bryanbendall/Brytec_InputModuleRev2/Board/Brytec_InputModuleRev2/Brytec_InputModuleRev2.kicad_pcb

## KiCad design Board/Brytec_InputModuleRev2/Brytec_InputModuleRev2.kicad_pcb (2024-01-26)

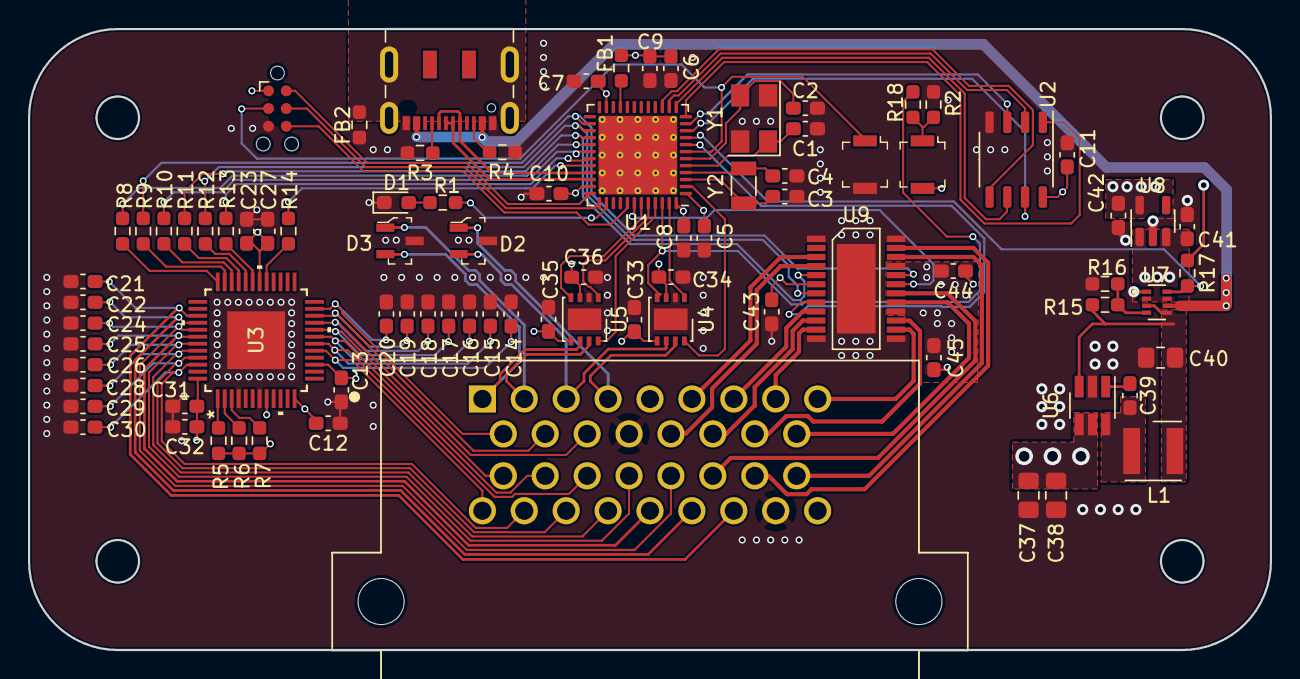
[picture p1: board Brytec_InputModuleRev2.kicad_pcb from above]

Board: 4 copper layers, 88.9 x 44.5 mm, 85 parts (0 on the bottom side), 88 nets.

Parts:
C1, C2, C3, C4: 10pF; C_0603_1608Metric_Pad1.08x0.95mm_HandSolder
C5, C7, C8, C10, C11, C12, C13, C27, C32, C33, C34, C35, C36, C39, C43, C44, C45: 0.1uF; C_0603_1608Metric_Pad1.08x0.95mm_HandSolder
C6, C23, C31, C41, C42: 1uF; C_0603_1608Metric_Pad1.08x0.95mm_HandSolder
C9: 10nF; C_0603_1608Metric_Pad1.08x0.95mm_HandSolder
C14, C15, C16, C17, C18, C19, C20, C21, C22, C24, C25, C26, C28, C29, C30: 6.8nF; C_0603_1608Metric_Pad1.08x0.95mm_HandSolder
C37: 4.7uF; C_0805_2012Metric_Pad1.18x1.45mm_HandSolder
C38: 0.1uF; C_0805_2012Metric_Pad1.18x1.45mm_HandSolder
C40: 10uF; C_0805_2012Metric_Pad1.18x1.45mm_HandSolder
D1: LED_Small; LED_0603_1608Metric_Pad1.05x0.95mm_HandSolder
D2, D3: PESD2CAN_215; SOT-23-3
FB1, FB2: FerriteBead_Small; R_0603_1608Metric_Pad0.98x0.95mm_HandSolder
J1: Conn_ARM_SWD_TagConnect_TC2030-NL; Tag-Connect_TC2030-IDC-NL_2x03_P1.27mm_Vertical
J2: USB_C_Receptacle_USB2.0; USB_C_Receptacle_JAE_DX07S016JA1R1500
J3: 6437288-2; TE_6437288-2
L1: 6.8uH; L_Wurth_WE-LQSH-4020
R1: 65; R_0603_1608Metric_Pad0.98x0.95mm_HandSolder
R2, R15, R16, R17: 10K; R_0603_1608Metric_Pad0.98x0.95mm_HandSolder
R3, R4: 5.1K; R_0603_1608Metric_Pad0.98x0.95mm_HandSolder
R5: 50K; R_0603_1608Metric_Pad0.98x0.95mm_HandSolder
R6: 9K; R_0603_1608Metric_Pad0.98x0.95mm_HandSolder
R7: 180; R_0603_1608Metric_Pad0.98x0.95mm_HandSolder
R8, R9, R10, R11, R12, R13, R14: 1K; R_0603_1608Metric_Pad0.98x0.95mm_HandSolder
R18: 0; R_0603_1608Metric_Pad0.98x0.95mm_HandSolder
S1, S2: B3U-1000P; Switch_Tactile_SMD_B3U-1000P
U1: STM32G491CEUx; QFN-48-1EP_7x7mm_P0.5mm_EP5.6x5.6mm_ThermalVias
U2: MB85RS64; SSOP-8_3.9x5.05mm_P1.27mm
U3: L9966CB-TR; TQFP48_L9966_STM
U4, U5: MCP2558FD-xMF; DFN-8-1EP_3x3mm_P0.65mm_EP1.55x2.4mm
U6: LMR50410Y5FQDBVRQ1; SOT-23-6_Handsoldering
U7: TPS2116DRLR; SOTFL50P160X60-8N
U8: AP2112K-3.3; SOT-23-5
U9: TLE94112ES; Infineon_TSDSO-24
Y1: 8MHz; Crystal_SMD_5032-4Pin_5.0x3.2mm
Y2: 32.768kHz; Crystal_SMD_3215-2Pin_3.2x1.5mm

Connections:
+3.3V: C5.2, C6.2, C7.2, C8.2, C9.2, C10.2, C11.1, C33.1, C35.1, C42.1, C43.2, FB1.1, J1.1 (VCC), R17.1, S2.2, U1.1 (VBAT), U1.23 (VDD), U1.35 (VDD), U1.48 (VDD), U2.8 (VDD), U4.5 (VIO), U5.5 (VIO), U8.5 (VOUT), U9.6 (VDD)
+5V: C12.2, C23.1, C27.1, C34.1, C36.1, C41.1, J3.5, R5.1, R6.1, R7.1, U3.8 (VDD5REF), U3.12 (VI5V), U3.30 (VDD5V), U4.3 (VDD), U5.3 (VDD), U7.2 (VOUT), U7.7 (VOUT), U8.1 (VIN), U8.3 (EN)
/Mcu/Memory_Hold: U1.10 (PA2), U2.7 (~HOLD)
/Mcu/Memory_Wp: U1.11 (PA3), U2.3 (~WP)
/Mcu/RESET: J1.3 (~RESET), S1.1, U1.7 (PG10)
/Mcu/SWCLK: J1.4 (SWCLK), U1.37 (PA14)
/Mcu/SWDIO: J1.2 (SWDIO), U1.36 (PA13)
/Mcu/SWO: J1.6 (SWO), U1.41 (PB3)
/Mcu/Usb D+: J2.A6 (D+), J2.B6 (D+), U1.34 (PA12)
/Mcu/Usb D-: J2.A7 (D-), J2.B7 (D-), U1.33 (PA11)
/Mcu/Usb_Shield: FB2.1, J2.S1 (SHIELD)
/Mcu/User_Led: R1.1, U1.38 (PA15)
Can1+: D2.1 (C1), J3.4, U4.7 (CANH)
Can1-: D2.2 (C2), J3.3, U4.6 (CANL)
Can1Rx: R18.1, U1.46 (PB8), U4.4 (RXD)
Can1Silent: U1.2 (PC13), U4.8 (S)
Can1Tx: U1.47 (PB9), U4.1 (TXD)
Can2+: D3.1 (C1), J3.2, U5.7 (CANH)
Can2-: D3.2 (C2), J3.1, U5.6 (CANL)
Can2Rx: U1.43 (PB5), U5.4 (RXD)
Can2Silent: U1.45 (PB7), U5.8 (S)
Can2Tx: U1.44 (PB6), U5.1 (TXD)
GND: C1.1, C2.1, C3.1, C4.1, C5.1, C6.1, C7.1, C8.1, C9.1, C10.1, C11.2, C12.1, C13.1, C14.2, C15.2, C16.2, C17.2, C18.2, C19.2, C20.2, C21.2, C22.2, C23.2, C24.2, C25.2, C26.2, C27.2, C28.2, C29.2, C30.2, C31.2, C32.2, C33.2, C34.2, C35.2, C36.2, C37.2, C38.2, C40.2, C41.2, C42.2, C43.1, C44.1, C45.1, D1.1 (K), D2.3 (C3), D3.3 (C3), FB2.2, J1.5 (GND), J2.A1 (GND), J2.A12 (GND), J2.B1 (GND), J2.B12 (GND), J3.13, J3.33, R2.2, R3.2, R4.2, R16.2, S1.2, U1.49 (VSS), U2.4 (GND), U3.4 (R_GND), U3.7 (GND), U3.EPAD, U4.2 (VSS), U4.9 (VSS), U5.2 (VSS), U5.9 (VSS), U6.2 (GND), U7.1 (GND), U8.2 (GND), U9.1 (GND), U9.12 (GND), U9.13 (GND), U9.24 (GND), U9.EDP (GND), Y1.2, Y1.4
Ignition: C13.2, C31.1, C32.1, C37.1, C38.1, C44.2, C45.2, J3.34, U3.15 (VIX), U3.48 (UBSW), U6.4 (EN), U6.5 (VIN), U9.16 (VS1), U9.21 (VS2)
Input1: C30.1, J3.27, U3.46 (IO_5)
Input2: C29.1, J3.28, U3.45 (IO_6)
Input3: C28.1, J3.29, U3.44 (IO_7)
Input4: C26.1, J3.21, U3.43 (IO_8)
Input5: C25.1, J3.30, U3.42 (IO_9)
Input6: C24.1, J3.22, U3.41 (IO_10)
Input7: C22.1, J3.31, U3.40 (IO_11)
Input8: C21.1, J3.32, U3.39 (IO_12)
Input9: C14.1, J3.26, U3.17 (IO_13)
Input10: C15.1, J3.20, U3.18 (IO_14)
Input11: C16.1, J3.19, U3.19 (IO_15)
Input12: C17.1, J3.18, U3.20 (IO_1)
Input13: C18.1, J3.12, U3.21 (IO_2)
Input14: C19.1, J3.11, U3.22 (IO_3)
Input15: C20.1, J3.10, U3.23 (IO_4)
L6699-Int: R14.2, U1.32 (PA10)
L6699-Rst: R8.2, U1.29 (PC6)
L6699-Sync: R13.2, U1.31 (PA9)
unnamed: D1.2 (A), R1.2
unnamed: J2.A5 (CC1), R4.1
unnamed: J2.B5 (CC2), R3.1
unnamed: R2.1, R18.2, S2.1
unnamed: C3.2, U1.3 (PC14), Y2.2
unnamed: C4.2, U1.4 (PC15), Y2.1
unnamed: C1.2, U1.5 (PF0), Y1.1
unnamed: C2.2, U1.6 (PF1), Y1.3
unnamed: FB1.2, U1.21 (VDDA)
unnamed: R10.1, U3.34 (CS)
unnamed: R14.1, U3.29 (INT)
unnamed: R12.1, U3.32 (MISO)
unnamed: R11.1, U3.33 (MOSI)
unnamed: R7.2, U3.3 (RR1)
unnamed: R6.2, U3.2 (RR2)
unnamed: R5.2, U3.1 (RR3)
unnamed: R8.1, U3.36 (RST)
unnamed: R9.1, U3.35 (SCLK)
unnamed: R13.1, U3.31 (SYNC)
unnamed: C39.2, U6.1 (CB)
unnamed: C39.1, L1.1, U6.6 (SW)
unnamed: R15.2, R16.1, U7.4 (PR1)
Out2: J3.24, U9.23 (OUT2)
Out3: J3.9, U9.14 (OUT3)
Out4: J3.8, U9.11 (OUT4)
Out5: J3.6, U9.3 (OUT5)
Out6: J3.15, U9.10 (OUT6)
Out7: J3.14, U9.4 (OUT7)
Out8: J3.25, U9.22 (OUT8)
Out9: J3.7, U9.9 (OUT9)
Out10: J3.16, U9.15 (OUT10)
Out11: J3.17, U9.17 (OUT11)
Out12: J3.23, U9.18 (OUT12)
PowerSwitchStatus: R17.2, U1.9 (PA1), U7.8 (ST)
Regulated 5V: C40.1, L1.2, R15.1, U6.3 (FB), U7.3 (VIN1), U7.5 (MODE)
SPI1_Miso: U1.14 (PA6), U2.2 (SO)
SPI1_Mosi: U1.15 (PA7), U2.5 (SI)
SPI1_SS: U1.12 (PA4), U2.1 (~CS)
SPI1_Sclk: U1.13 (PA5), U2.6 (SCK)
SPI2_Miso: R12.2, U1.27 (PB14), U9.7 (SDO)
SPI2_Mosi: R11.2, U1.28 (PB15), U9.5 (SDI)
SPI2_SS_L9966: R10.2, U1.30 (PA8)
SPI2_SS_TLE94112: U1.42 (PB4), U9.19 (CSN)
SPI2_Sclk: R9.2, U1.26 (PB13), U9.20 (SCLK)
TLE94112_EN: U1.8 (PA0), U9.8 (EN)
Usb 5V: J2.A4 (VBUS), J2.A9 (VBUS), J2.B4 (VBUS), J2.B9 (VBUS), U7.6 (VIN2)
