bryanbendall/Brytec_InputModuleRev2/Firmware/InputModuleRev2.ioc

Mcu.UserName=STM32G491CEUx
PA0.GPIO_Label=TLE94112_EN
PA0.Signal=GPIO_Output
PA1.GPIO_Label=PowerSwitchStatus
PA1.Signal=GPIO_Input
PA10.GPIO_Label=L9966-Int
PA10.Signal=GPIO_Input
PA11.Signal=USB_DM
PA12.Signal=USB_DP
PA13.Signal=SYS_JTMS-SWDIO
PA14.Signal=SYS_JTCK-SWCLK
PA15.GPIO_Label=User_Led
PA15.Signal=GPIO_Output
PA2.GPIO_Label=Memory_Hold
PA2.Signal=GPIO_Output
PA3.GPIO_Label=Memory_Wp
PA3.Signal=GPIO_Output
PA4.GPIO_Label=Memory_SS
PA4.Signal=GPIO_Output
PA5.Signal=SPI1_SCK
PA6.Signal=SPI1_MISO
PA7.Signal=SPI1_MOSI
PA8.GPIO_Label=SPI_SS_L9966
PA8.Signal=GPIO_Output
PA9.GPIO_Label=L9966-Sync
PA9.Signal=GPIO_Output
PB13.Signal=SPI2_SCK
PB14.Signal=SPI2_MISO
PB15.Signal=SPI2_MOSI
PB4.GPIO_Label=SPI2_SS_TLE94112
PB4.Signal=GPIO_Output
PB5.Signal=FDCAN2_RX
PB6.Signal=FDCAN2_TX
PB7.GPIO_Label=Can2Silent
PB7.Signal=GPIO_Output
PB8-BOOT0.Signal=FDCAN1_RX
PB9.Signal=FDCAN1_TX
PC13.GPIO_Label=Can1Silent
PC13.Signal=GPIO_Output
PC14-OSC32_IN.Signal=RCC_OSC32_IN
PC15-OSC32_OUT.Signal=RCC_OSC32_OUT
PC6.GPIO_Label=L9966-Rst
PC6.Signal=GPIO_Output
PF0-OSC_IN.Signal=RCC_OSC_IN
PF1-OSC_OUT.Signal=RCC_OSC_OUT
