bryanbendall/Brytec_InputModuleRev2/Firmware/App/BoardHardware.cpp

#include "BoardHardware.h"

#include "Stm32Output.h"
#include "spi.h"
#include <stdio.h>

enum class SpiState {
    TLE94112,
    L9966
};

static SpiState s_spiState = SpiState::TLE94112;

bool BoardHardware::getIgntionPowerState()
{
    return HAL_GPIO_ReadPin(PowerSwitchStatus_GPIO_Port, PowerSwitchStatus_Pin);
}

void BoardHardware::setSpiTLE94112()
{
    if (s_spiState == SpiState::TLE94112)
        return;

    HAL_SPI_DeInit(&hspi2);

    hspi2.Instance = SPI2;
    hspi2.Init.Mode = SPI_MODE_MASTER;
    hspi2.Init.Direction = SPI_DIRECTION_2LINES;
    hspi2.Init.DataSize = SPI_DATASIZE_8BIT;
    hspi2.Init.CLKPolarity = SPI_POLARITY_LOW;
    hspi2.Init.CLKPhase = SPI_PHASE_2EDGE;
    hspi2.Init.NSS = SPI_NSS_SOFT;
    hspi2.Init.BaudRatePrescaler = SPI_BAUDRATEPRESCALER_32;
    hspi2.Init.FirstBit = SPI_FIRSTBIT_LSB;
    hspi2.Init.TIMode = SPI_TIMODE_DISABLE;
    hspi2.Init.CRCCalculation = SPI_CRCCALCULATION_DISABLE;
    hspi2.Init.CRCPolynomial = 7;
    hspi2.Init.CRCLength = SPI_CRC_LENGTH_DATASIZE;
    hspi2.Init.NSSPMode = SPI_NSS_PULSE_DISABLE;
    if (HAL_SPI_Init(&hspi2) != HAL_OK) {
        Error_Handler();
    }

    s_spiState = SpiState::TLE94112;
}

void BoardHardware::setSpiL9966()
{
    if (s_spiState == SpiState::L9966)
        return;

    HAL_SPI_DeInit(&hspi2);

    hspi2.Instance = SPI2;
    hspi2.Init.Mode = SPI_MODE_MASTER;
    hspi2.Init.Direction = SPI_DIRECTION_2LINES;
    hspi2.Init.DataSize = SPI_DATASIZE_16BIT;
    hspi2.Init.CLKPolarity = SPI_POLARITY_LOW;
    hspi2.Init.CLKPhase = SPI_PHASE_2EDGE;
    hspi2.Init.NSS = SPI_NSS_SOFT;
    hspi2.Init.BaudRatePrescaler = SPI_BAUDRATEPRESCALER_32;
    hspi2.Init.FirstBit = SPI_FIRSTBIT_MSB;
    hspi2.Init.TIMode = SPI_TIMODE_DISABLE;
    hspi2.Init.CRCCalculation = SPI_CRCCALCULATION_DISABLE;
    hspi2.Init.CRCPolynomial = 7;
    hspi2.Init.CRCLength = SPI_CRC_LENGTH_DATASIZE;
    hspi2.Init.NSSPMode = SPI_NSS_PULSE_DISABLE;
    if (HAL_SPI_Init(&hspi2) != HAL_OK) {
        Error_Handler();
    }

    s_spiState = SpiState::L9966;
}
