bryanbendall/Brytec_InputModuleRev2/Firmware/Core/Inc/main.h

#define Can1Silent_Pin GPIO_PIN_13
#define Can1Silent_GPIO_Port GPIOC
#define TLE94112_EN_Pin GPIO_PIN_0
#define TLE94112_EN_GPIO_Port GPIOA
#define PowerSwitchStatus_Pin GPIO_PIN_1
#define PowerSwitchStatus_GPIO_Port GPIOA
#define Memory_Hold_Pin GPIO_PIN_2
#define Memory_Hold_GPIO_Port GPIOA
#define Memory_Wp_Pin GPIO_PIN_3
#define Memory_Wp_GPIO_Port GPIOA
#define Memory_SS_Pin GPIO_PIN_4
#define Memory_SS_GPIO_Port GPIOA
#define L9966_Rst_Pin GPIO_PIN_6
#define L9966_Rst_GPIO_Port GPIOC
#define SPI_SS_L9966_Pin GPIO_PIN_8
#define SPI_SS_L9966_GPIO_Port GPIOA
#define L9966_Sync_Pin GPIO_PIN_9
#define L9966_Sync_GPIO_Port GPIOA
#define L9966_Int_Pin GPIO_PIN_10
#define L9966_Int_GPIO_Port GPIOA
#define User_Led_Pin GPIO_PIN_15
#define User_Led_GPIO_Port GPIOA
#define SPI2_SS_TLE94112_Pin GPIO_PIN_4
#define SPI2_SS_TLE94112_GPIO_Port GPIOB
#define Can2Silent_Pin GPIO_PIN_7
#define Can2Silent_GPIO_Port GPIOB
