bryanbendall/Brytec_InputModuleRev2/Firmware/App/InputModuleRev2Defs-5Vmod.h

#pragma once

#include <stdint.h>

// Pin Defines
#define BT_PIN_Onboard_LED 0
#define BT_PIN_Pin_6 1
#define BT_PIN_Pin_7 2
#define BT_PIN_Pin_8 3
#define BT_PIN_Pin_9 4
#define BT_PIN_Pin_10 5
#define BT_PIN_Pin_11 6
#define BT_PIN_Pin_12 7
#define BT_PIN_Pin_14 8
#define BT_PIN_Pin_15 9
#define BT_PIN_Pin_16 10
#define BT_PIN_Pin_17 11
#define BT_PIN_Pin_18 12
#define BT_PIN_Pin_19 13
#define BT_PIN_Pin_20 14
#define BT_PIN_Pin_21 15
#define BT_PIN_Pin_22 16
#define BT_PIN_Pin_23 17
#define BT_PIN_Pin_24 18
#define BT_PIN_Pin_25 19
#define BT_PIN_Pin_26 20
#define BT_PIN_Pin_27 21
#define BT_PIN_Pin_28 22
#define BT_PIN_Pin_29 23
#define BT_PIN_Pin_30 24
#define BT_PIN_Pin_31 25
#define BT_PIN_Pin_32 26

// Can Bus Defines
#define BT_CAN_Pin_4_Pin_3 0
#define BT_CAN_Pin_2_Pin_1 1

// Module Template
constexpr uint8_t moduleTemplate[] = {
0x54,0x4d,0,0x1,0x1b,0,0,0,0x49,0x6e,0x70,0x75,0x74,0x20,0x4d,0x6f,0x64,0x75,0x6c,0x65,0x20,0x52,0x65,0x76,0x20,0x32,0x20,0x2d,0x20,0x35,0x56,0x20,0x6d,0x6f,0x64,0x6,0,0,0,0x42,0x72,0x79,0x74,0x65,0x63,0x1b,0,0,0,0x49,0x6e,0x70,0x75,0x74,0x20,0x4d,0x6f,0x64,0x75,0x6c,0x65,0x20,0x52,0x65,0x76,0x20,0x32,0x20,0x2d,0x20,0x35,0x56,0x20,0x6d,0x6f,0x64,0x50,0x2,0x5,0,0,0,0x50,0x69,0x6e,0x20,0x34,0x5,0,0,0,0x50,0x69,0x6e,0x20,0x33,0x5,0,0,0,0x50,0x69,0x6e,0x20,0x32,0x5,0,0,0,0x50,0x69,0x6e,0x20,0x31,0x1b,0,0xb,0,0,0,0x4f,0x6e,0x62,0x6f,0x61,0x72,0x64,0x20,0x4c,0x45,0x44,0x1,0x1,0,0,0x5,0,0,0,0x50,0x69,0x6e,0x20,0x36,0x2,0x2,0x3,0x2,0x1,0x5,0,0,0,0x50,0x69,0x6e,0x20,0x37,0x2,0x2,0x3,0x2,0x1,0x5,0,0,0,0x50,0x69,0x6e,0x20,0x38,0x2,0x2,0x3,0x2,0x1,0x5,0,0,0,0x50,0x69,0x6e,0x20,0x39,0x2,0x2,0x3,0x2,0x1,0x6,0,0,0,0x50,0x69,0x6e,0x20,0x31,0x30,0x7,0x4,0x5,0x6,0x7,0x8,0x9,0x1,0,0,0x6,0,0,0,0x50,0x69,0x6e,0x20,0x31,0x31,0x7,0x4,0x5,0x6,0x7,0x8,0x9,0x1,0,0,0x6,0,0,0,0x50,0x69,0x6e,0x20,0x31,0x32,0x6,0x4,0x5,0x6,0x7,0x8,0x9,0,0,0x6,0,0,0,0x50,0x69,0x6e,0x20,0x31,0x34,0x2,0x2,0x3,0x2,0x1,0x6,0,0,0,0x50,0x69,0x6e,0x20,0x31,0x35,0x2,0x2,0x3,0x2,0x1,0x6,0,0,0,0x50,0x69,0x6e,0x20,0x31,0x36,0x2,0x2,0x3,0x2,0x1,0x6,0,0,0,0x50,0x69,0x6e,0x20,0x31,0x37,0x2,0x2,0x3,0x2,0x1,0x6,0,0,0,0x50,0x69,0x6e,0x20,0x31,0x38,0x6,0x4,0x5,0x6,0x7,0x8,0x9,0,0,0x6,0,0,0,0x50,0x69,0x6e,0x20,0x31,0x39,0x3,0x4,0x5,0x6,0,0,0x6,0,0,0,0x50,0x69,0x6e,0x20,0x32,0x30,0x3,0x4,0x5,0x6,0,0,0x6,0,0,0,0x50,0x69,0x6e,0x20,0x32,0x31,0x6,0x4,0x5,0x6,0x7,0x8,0x9,0,0,0x6,0,0,0,0x50,0x69,0x6e,0x20,0x32,0x32,0x6,0x4,0x5,0x6,0x7,0x8,0x9,0,0,0x6,0,0,0,0x50,0x69,0x6e,0x20,0x32,0x33,0x2,0x2,0x3,0x2,0x1,0x6,0,0,0,0x50,0x69,0x6e,0x20,0x32,0x34,0x2,0x2,0x3,0x2,0x1,0x6,0,0,0,0x50,0x69,0x6e,0x20,0x32,0x35,0x2,0x2,0x3,0x2,0x1,0x6,0,0,0,0x50,0x69,0x6e,0x20,0x32,0x36,0x3,0x4,0x5,0x6,0,0,0x6,0,0,0,0x50,0x69,0x6e,0x20,0x32,0x37,0x7,0x4,0x5,0x6,0x7,0x8,0x9,0x1,0,0,0x6,0,0,0,0x50,0x69,0x6e,0x20,0x32,0x38,0x7,0x4,0x5,0x6,0x7,0x8,0x9,0x1,0,0,0x6,0,0,0,0x50,0x69,0x6e,0x20,0x32,0x39,0x6,0x4,0x5,0x6,0x7,0x8,0x9,0,0,0x6,0,0,0,0x50,0x69,0x6e,0x20,0x33,0x30,0x6,0x4,0x5,0x6,0x7,0x8,0x9,0,0,0x6,0,0,0,0x50,0x69,0x6e,0x20,0x33,0x31,0x6,0x4,0x5,0x6,0x7,0x8,0x9,0,0,0x6,0,0,0,0x50,0x69,0x6e,0x20,0x33,0x32,0x6,0x4,0x5,0x6,0x7,0x8,0x9,0,0,
};
