bryanbendall/Brytec_InputModuleRev2/Firmware/App/cppMain.cpp

#include "cppMain.h"

#include "BoardHardware.h"
#include "CanBus.h"
#include "EBrytecApp.h"
#include "Fram.h"
#include "L9966.h"
#include "MsTimeout.h"
#include "TLE94112.h"
#include "UsDelay.h"
#include "Usb.h"
#include "spi.h"
#include "stm32g4xx_hal.h"
#include <stdint.h>

MsTimeout brytecTimer(10);

void cppMain()
{
    DWT_Delay_Init();

    Fram::init(&hspi1);

    BoardHardware::setSpiL9966();
    L9966::init(&hspi2);

    BoardHardware::setSpiTLE94112();
    TLE94112::init();

    Brytec::EBrytecApp::initalize();

    if (Brytec::EBrytecApp::isDeserializeOk())
        printf("Deserialize Ok\n");
    else
        printf("Deserialize FAIL\n");

    while (1) {

        Usb::update();

        Brytec::EBrytecApp::processCanCommands();

        if (brytecTimer.isTimeout())
            Brytec::EBrytecApp::update(brytecTimer.getTimestepMs());
    }
}
