bryanbendall/Brytec_InputModuleRev2/(commit log)

2023-08-29 Initial Board Work
    [Brytec_InputModuleRev2.kicad_pcb, Brytec_InputModuleRev2.kicad_sch, CanBus.kicad_sch, Connectors.kicad_sch, L9966.kicad_sch, Mcu.kicad_sch, PowerRegulation.kicad_sch, TLE94112ES.kicad_sch]
2023-09-02 Updated board
    [Brytec_InputModuleRev2.kicad_pcb, Connectors.kicad_sch, L9966.kicad_sch, Mcu.kicad_sch, TLE94112ES.kicad_sch]
2024-01-26 Board Files
    [Brytec_InputModuleRev2-B_Cu.gbl, Brytec_InputModuleRev2-B_Mask.gbs, Brytec_InputModuleRev2-B_Paste.gbp, Brytec_InputModuleRev2-B_Silkscreen.gbo, Brytec_InputModuleRev2-Edge_Cuts.gm1, Brytec_InputModuleRev2-F_Cu.gtl, Brytec_InputModuleRev2-F_Mask.gts, Brytec_InputModuleRev2-F_Paste.gtp]
2024-01-27 Change can bus defs into cpp file
2024-01-30 Updated for spi changes
2024-02-01 Updating board file
2024-02-03 Setup spi in config Set pin defaults
2024-02-18 Init us delay Working board with led
2024-02-19 Overwrite config for dual can bus
2024-03-03 Working board Changing Spi for different chips
2024-07-19 Added 5v mod
